samvasta/wing_it_hardware/Parts.md

# Parts

## Board Connection

### Main board

Plug: <https://www.digikey.com/product-detail/en/hirose-electric-co-ltd/PCN13-20S-2-54DS-71/H11185-ND/1036436>

### Hands

Receptacle: <https://www.digikey.com/product-detail/en/hirose-electric-co-ltd/PCN10-20P-2-54DS-72/H11156-ND/1036416>

## Module

To enable hot-swappable I2C modules, use one [PI6ULS5V9511AWEX](<https://www.digikey.com/product-detail/en/diodes-incorporated/PI6ULS5V9511AWEX/PI6ULS5V9511AWEXDICT-ND/8611258>) per module board.

### Analog Joystick

Tilt guard: 1.5mm acrylic sheet. See `cad/thumbstick_tilt_guard.dxf`

Standoff: [Würth Elektronik M3 6mm male-female hex standoff (digikey)](<https://www.digikey.com/product-detail/en/w%C3%BCrth-elektronik/971060321/732-10384-ND/6174603>)
