samvasta/wing_it_hardware/cad/specs.md

# CAD Specifications

## Holes

Prefer Imperial #4-40 hardware (screws, nuts, etc.).

_#4-40 nominal outer diameter:_ 2.84mm

_#4-40 clearance hole diameter:_ 3.25mm

## Parts

### Analog Thumbstick

The tilt stop is a circle 20mm diameter. Top of tilt stop is about 1/16" (17.48mm) from top of pcb.

Example: 1.5mm thick acrylic on top of 6mm standoff
