samvasta/wing_it_hardware/cad/kicad_import_pcb_main2.dxf

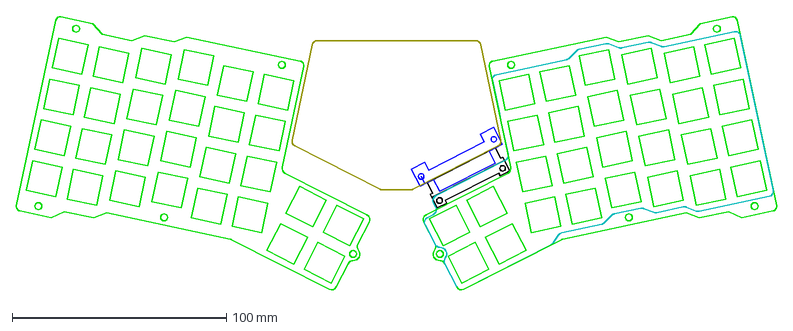
[picture p1: CAD file, 2020-05-02]
cad/kicad_import_pcb_main2.dxf
355.1 x 128.1 mm
