samvasta/wing_it_hardware/cad/kicad_import_pcb_main.dxf

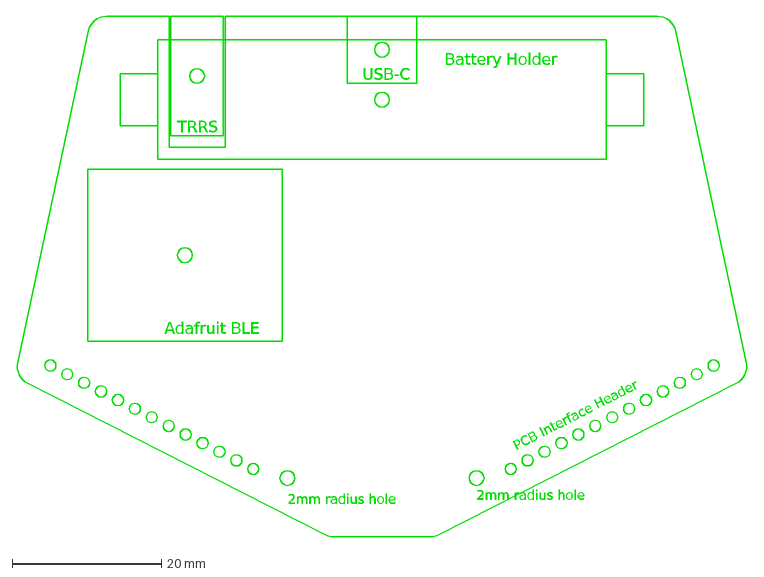
[picture p2: CAD file, 2020-04-02]
cad/kicad_import_pcb_main.dxf
USB-C
TRRS
Battery Holder
Adafruit BLE
2mm radius hole
PCB Interface Header
