samvasta/wing_it_hardware/cad/#all_in_one.dxf

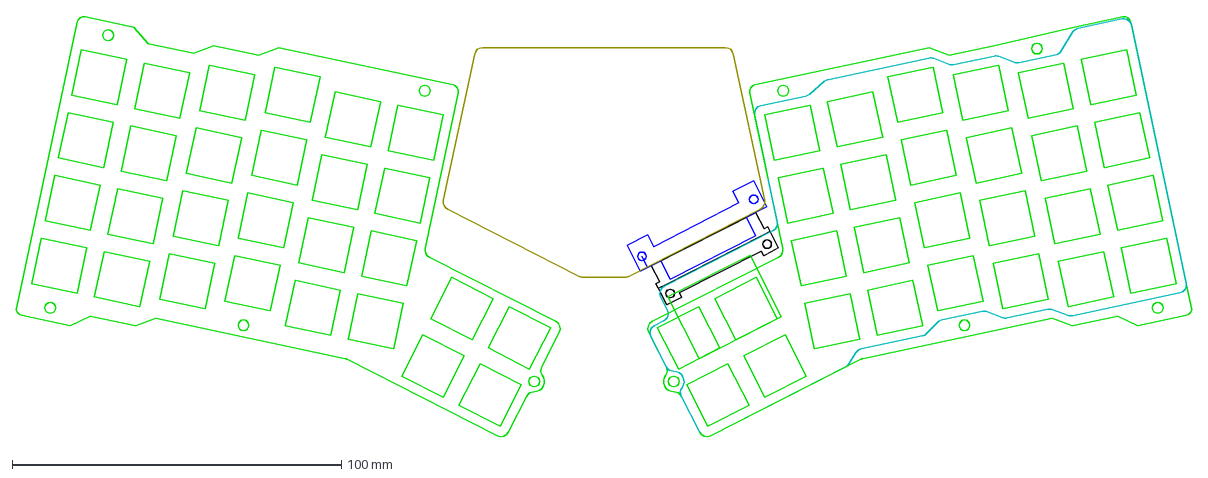
[picture p3: CAD file, 2020-05-28]
cad/#all_in_one.dxf
356.9 x 128.1 mm
