samvasta/wing_it_hardware/cad/kicad_import_pcb_hand2.dxf

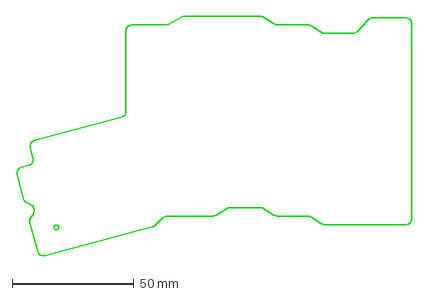
[picture p4: CAD file, 2020-05-02]
cad/kicad_import_pcb_hand2.dxf
162.7 x 98.8 mm
