samvasta/wing_it_hardware/cad/export_hand_bottom_plate.dxf

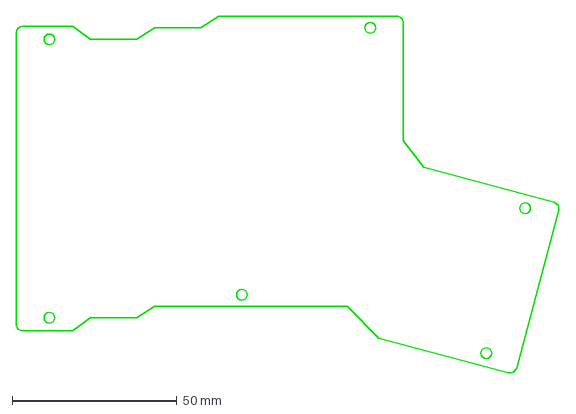
[picture p5: CAD file, 2020-04-14]
cad/export_hand_bottom_plate.dxf
165.1 x 108.6 mm
