samvasta/wing_it_hardware/cad/thumbstick_tilt_guard.dxf

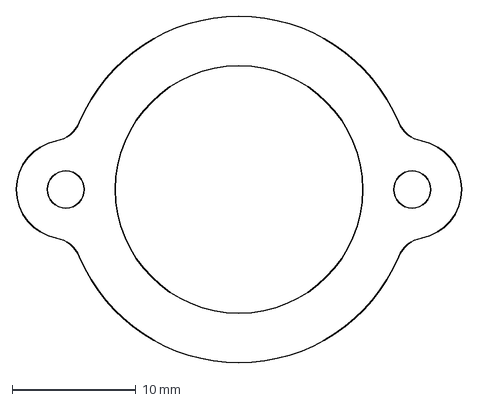
[picture p7: CAD file, 2020-04-05]
cad/thumbstick_tilt_guard.dxf
36.0 x 28.0 mm
