samvasta/wing_it_hardware/cad/kicad_import_pcb_hand.dxf

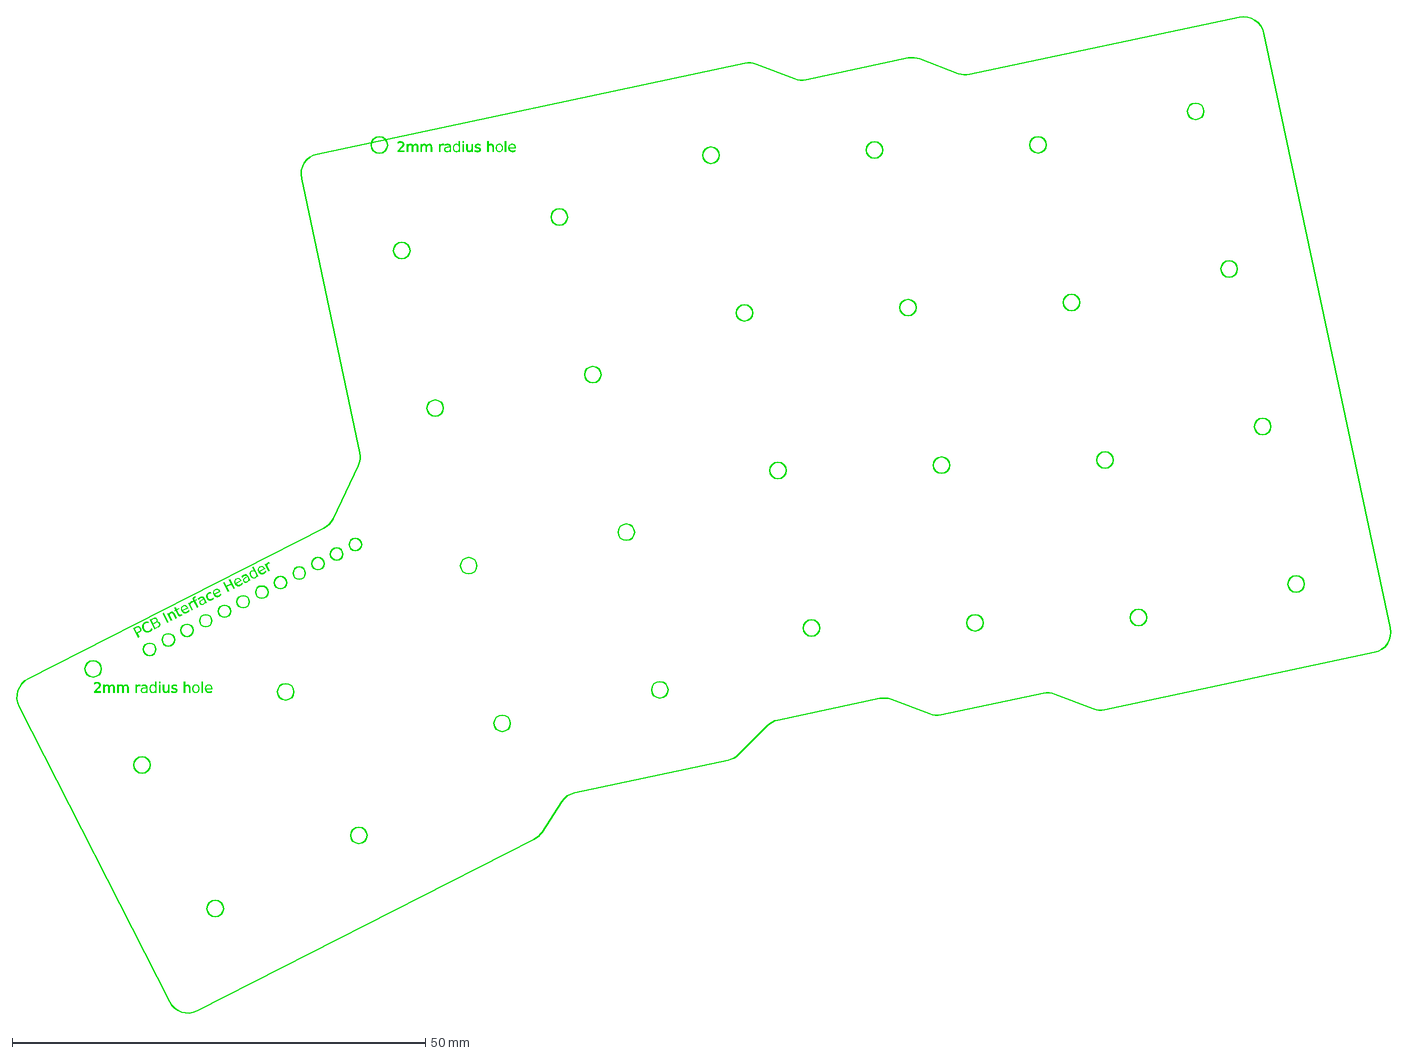
[picture p8: CAD file, 2020-04-02]
cad/kicad_import_pcb_hand.dxf
2mm radius hole
PCB Interface Header
