samvasta/wing_it_hardware/cad/kicad_import_switch_positions.dxf

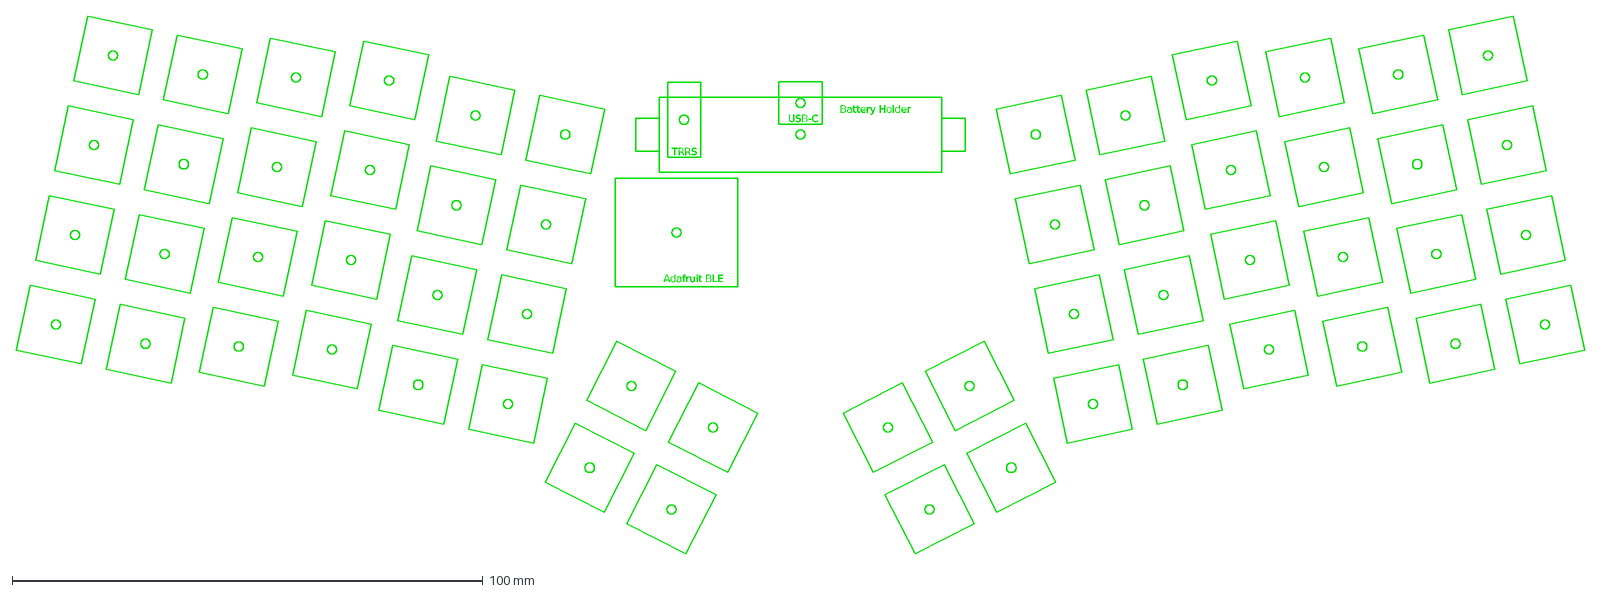
[picture p9: CAD file, 2020-03-29]
cad/kicad_import_switch_positions.dxf
USB-C
TRRS
Battery Holder
Adafruit BLE
