samvasta/wing_it_hardware/(list of files, cad)

Other CAD files:
cad/all_in_one.dxf
