samvasta/wing_it_hardware/pcb/pcb_hand/Keeb.kicad_pcb

## KiCad design pcb/pcb_hand/Keeb.kicad_pcb (2020-05-02)

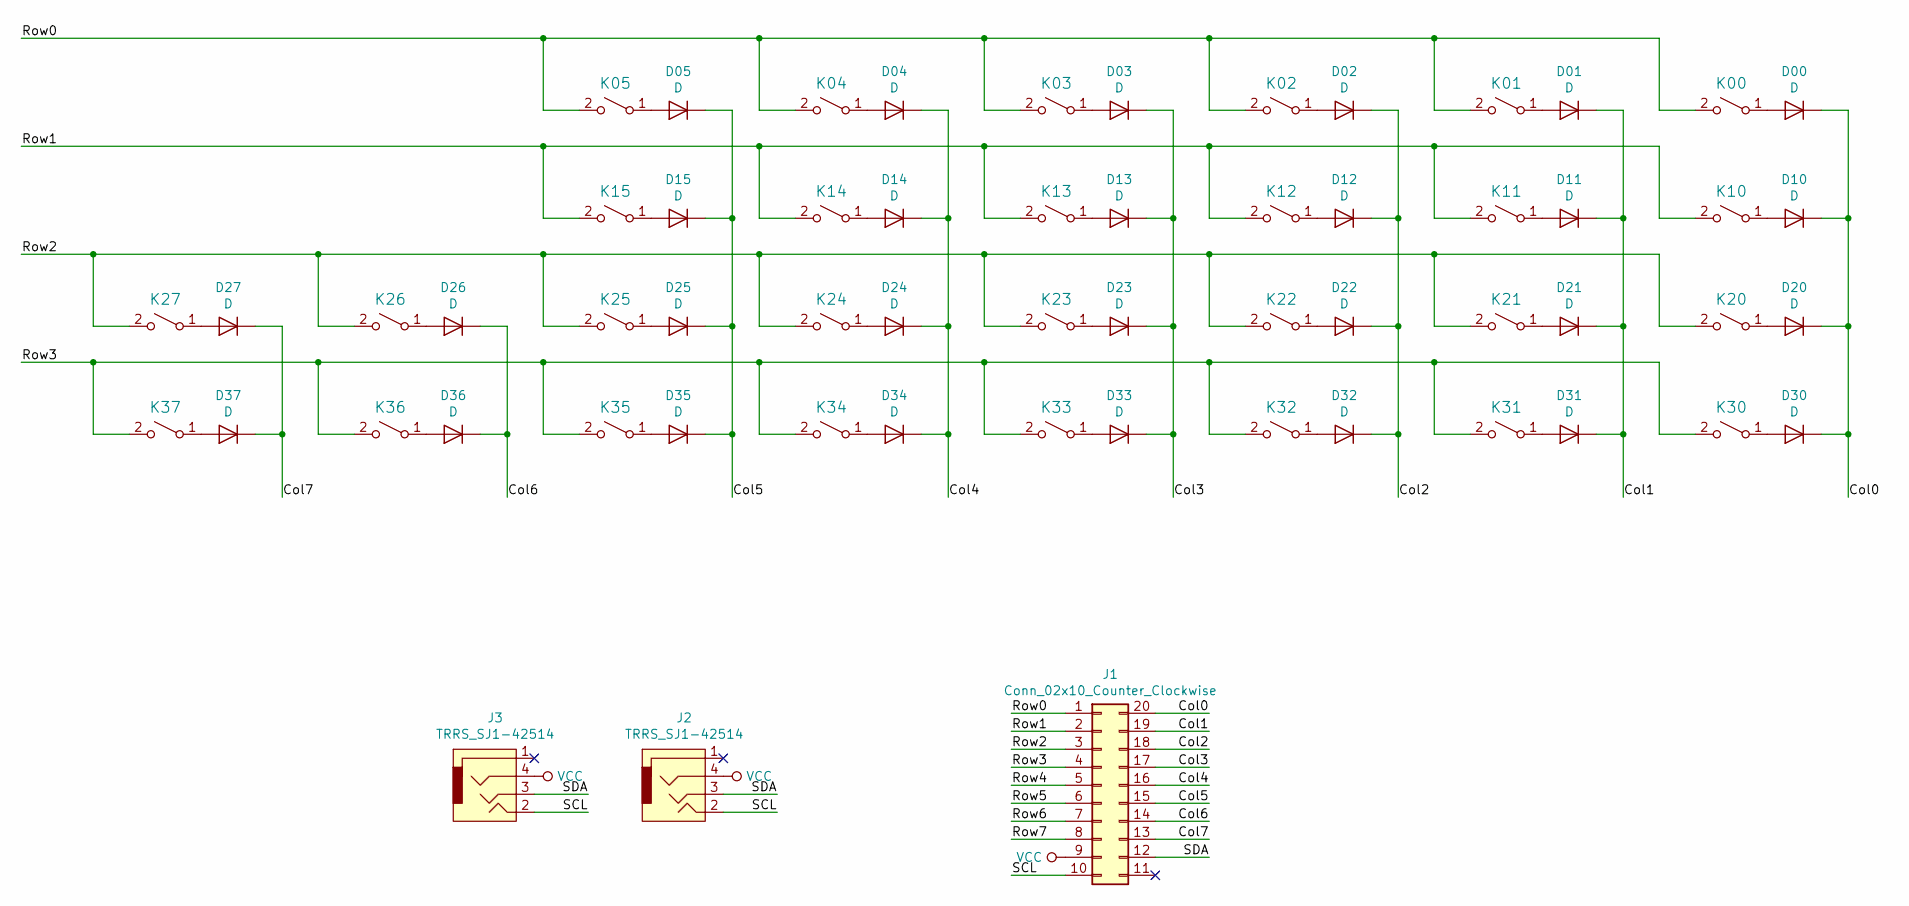
[picture p10: schematic Keeb.sch]

Parts:
D00, D01, D02, D03, D04, D05, D10, D11, D12, D13, D14, D15, D20, D21, D22, D23, D24, D25, D26, D27, D30, D31, D32, D33, D34, D35, D36, D37: D; D_MiniMELF_Handsoldering_Shorter_Pads_DoubleSided
J1: Conn_02x10_Counter_Clockwise; Backplane_Connector_Hirose_PCN_20pos_Receptacle
J2, J3: TRRS_SJ1-42514; 3.5mm_Cut_out
K00, K01, K02, K03, K04, K05, K10, K11, K12, K13, K14, K15, K20, K21, K22, K23, K24, K25, K26, K27, K30, K31, K32, K33, K34, K35, K36, K37: KEYSW; Kailh_socket_reversible

Connections:
/Col0: D00.1 (K), D10.1 (K), D20.1 (K), D30.1 (K), J1.20
/Col1: D01.1 (K), D11.1 (K), D21.1 (K), D31.1 (K), J1.19
/Col2: D02.1 (K), D12.1 (K), D22.1 (K), D32.1 (K), J1.18
/Col3: D03.1 (K), D13.1 (K), D23.1 (K), D33.1 (K), J1.17
/Col4: D04.1 (K), D14.1 (K), D24.1 (K), D34.1 (K), J1.16
/Col5: D05.1 (K), D15.1 (K), D25.1 (K), D35.1 (K), J1.15
/Col6: D26.1 (K), D36.1 (K), J1.14
/Col7: D27.1 (K), D37.1 (K), J1.13
/Row0: J1.1, K00.2 (B), K01.2 (B), K02.2 (B), K03.2 (B), K04.2 (B), K05.2 (B)
/Row1: J1.2, K10.2 (B), K11.2 (B), K12.2 (B), K13.2 (B), K14.2 (B), K15.2 (B)
/Row2: J1.3, K20.2 (B), K21.2 (B), K22.2 (B), K23.2 (B), K24.2 (B), K25.2 (B), K26.2 (B), K27.2 (B)
/Row3: J1.4, K30.2 (B), K31.2 (B), K32.2 (B), K33.2 (B), K34.2 (B), K35.2 (B), K36.2 (B), K37.2 (B)
/Row4: J1.5
/Row5: J1.6
/Row6: J1.7
/Row7: J1.8
/SCL: J1.10, J2.2, J3.2
/SDA: J1.12, J2.3, J3.3
unnamed: D00.2 (A), K00.1 (A)
unnamed: D01.2 (A), K01.1 (A)
unnamed: D02.2 (A), K02.1 (A)
unnamed: D03.2 (A), K03.1 (A)
unnamed: D04.2 (A), K04.1 (A)
unnamed: D05.2 (A), K05.1 (A)
unnamed: D10.2 (A), K10.1 (A)
unnamed: D11.2 (A), K11.1 (A)
unnamed: D12.2 (A), K12.1 (A)
unnamed: D13.2 (A), K13.1 (A)
unnamed: D14.2 (A), K14.1 (A)
unnamed: D15.2 (A), K15.1 (A)
unnamed: D20.2 (A), K20.1 (A)
unnamed: D21.2 (A), K21.1 (A)
unnamed: D22.2 (A), K22.1 (A)
unnamed: D23.2 (A), K23.1 (A)
unnamed: D24.2 (A), K24.1 (A)
unnamed: D25.2 (A), K25.1 (A)
unnamed: D26.2 (A), K26.1 (A)
unnamed: D27.2 (A), K27.1 (A)
unnamed: D30.2 (A), K30.1 (A)
unnamed: D31.2 (A), K31.1 (A)
unnamed: D32.2 (A), K32.1 (A)
unnamed: D33.2 (A), K33.1 (A)
unnamed: D34.2 (A), K34.1 (A)
unnamed: D35.2 (A), K35.1 (A)
unnamed: D36.2 (A), K36.1 (A)
unnamed: D37.2 (A), K37.1 (A)
VCC: J1.9, J2.4, J3.4

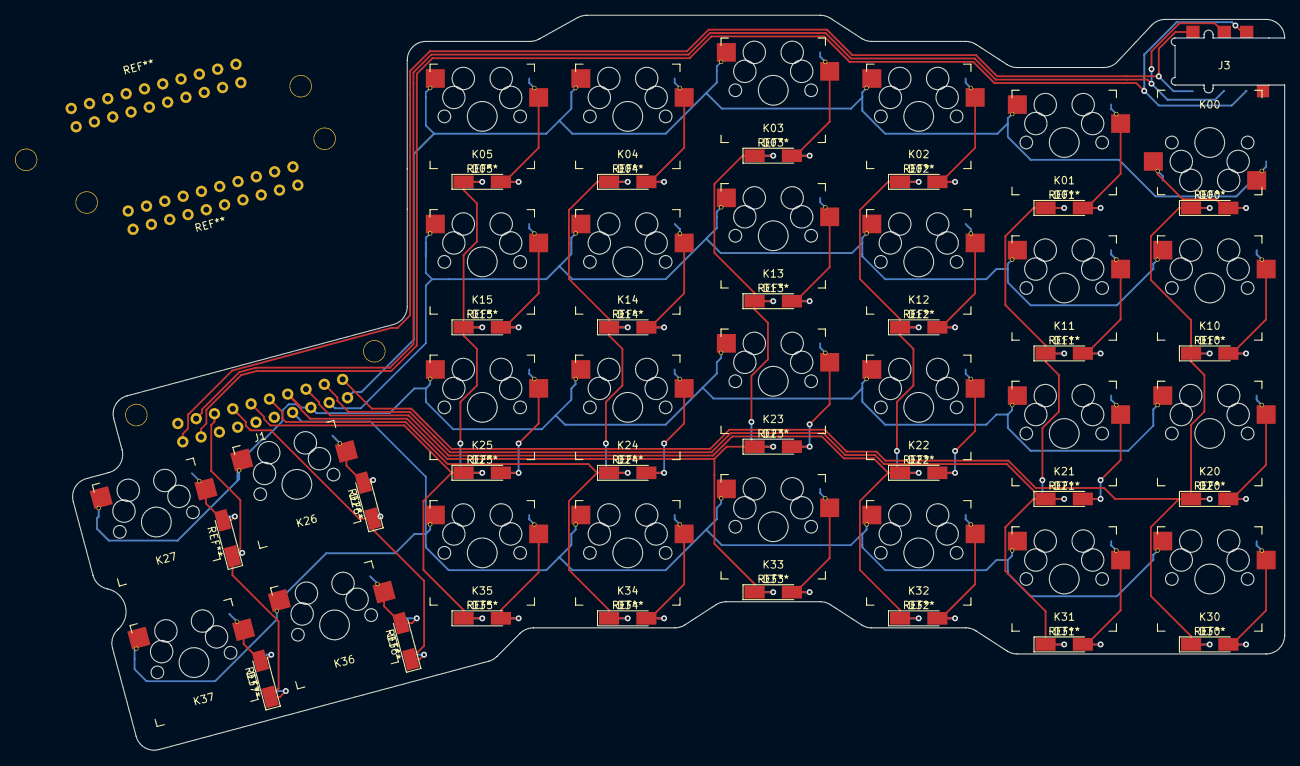
[picture p11: board pcb/pcb_hand/Keeb.kicad_pcb from above]

Board: 2 copper layers, 162.5 x 98.5 mm, 59 parts (1 on the bottom side), 43 nets.
