samvasta/wing_it_hardware/pcb/pcb_main/Keeb.kicad_pcb

## KiCad design pcb/pcb_main/Keeb.kicad_pcb (2020-05-02)

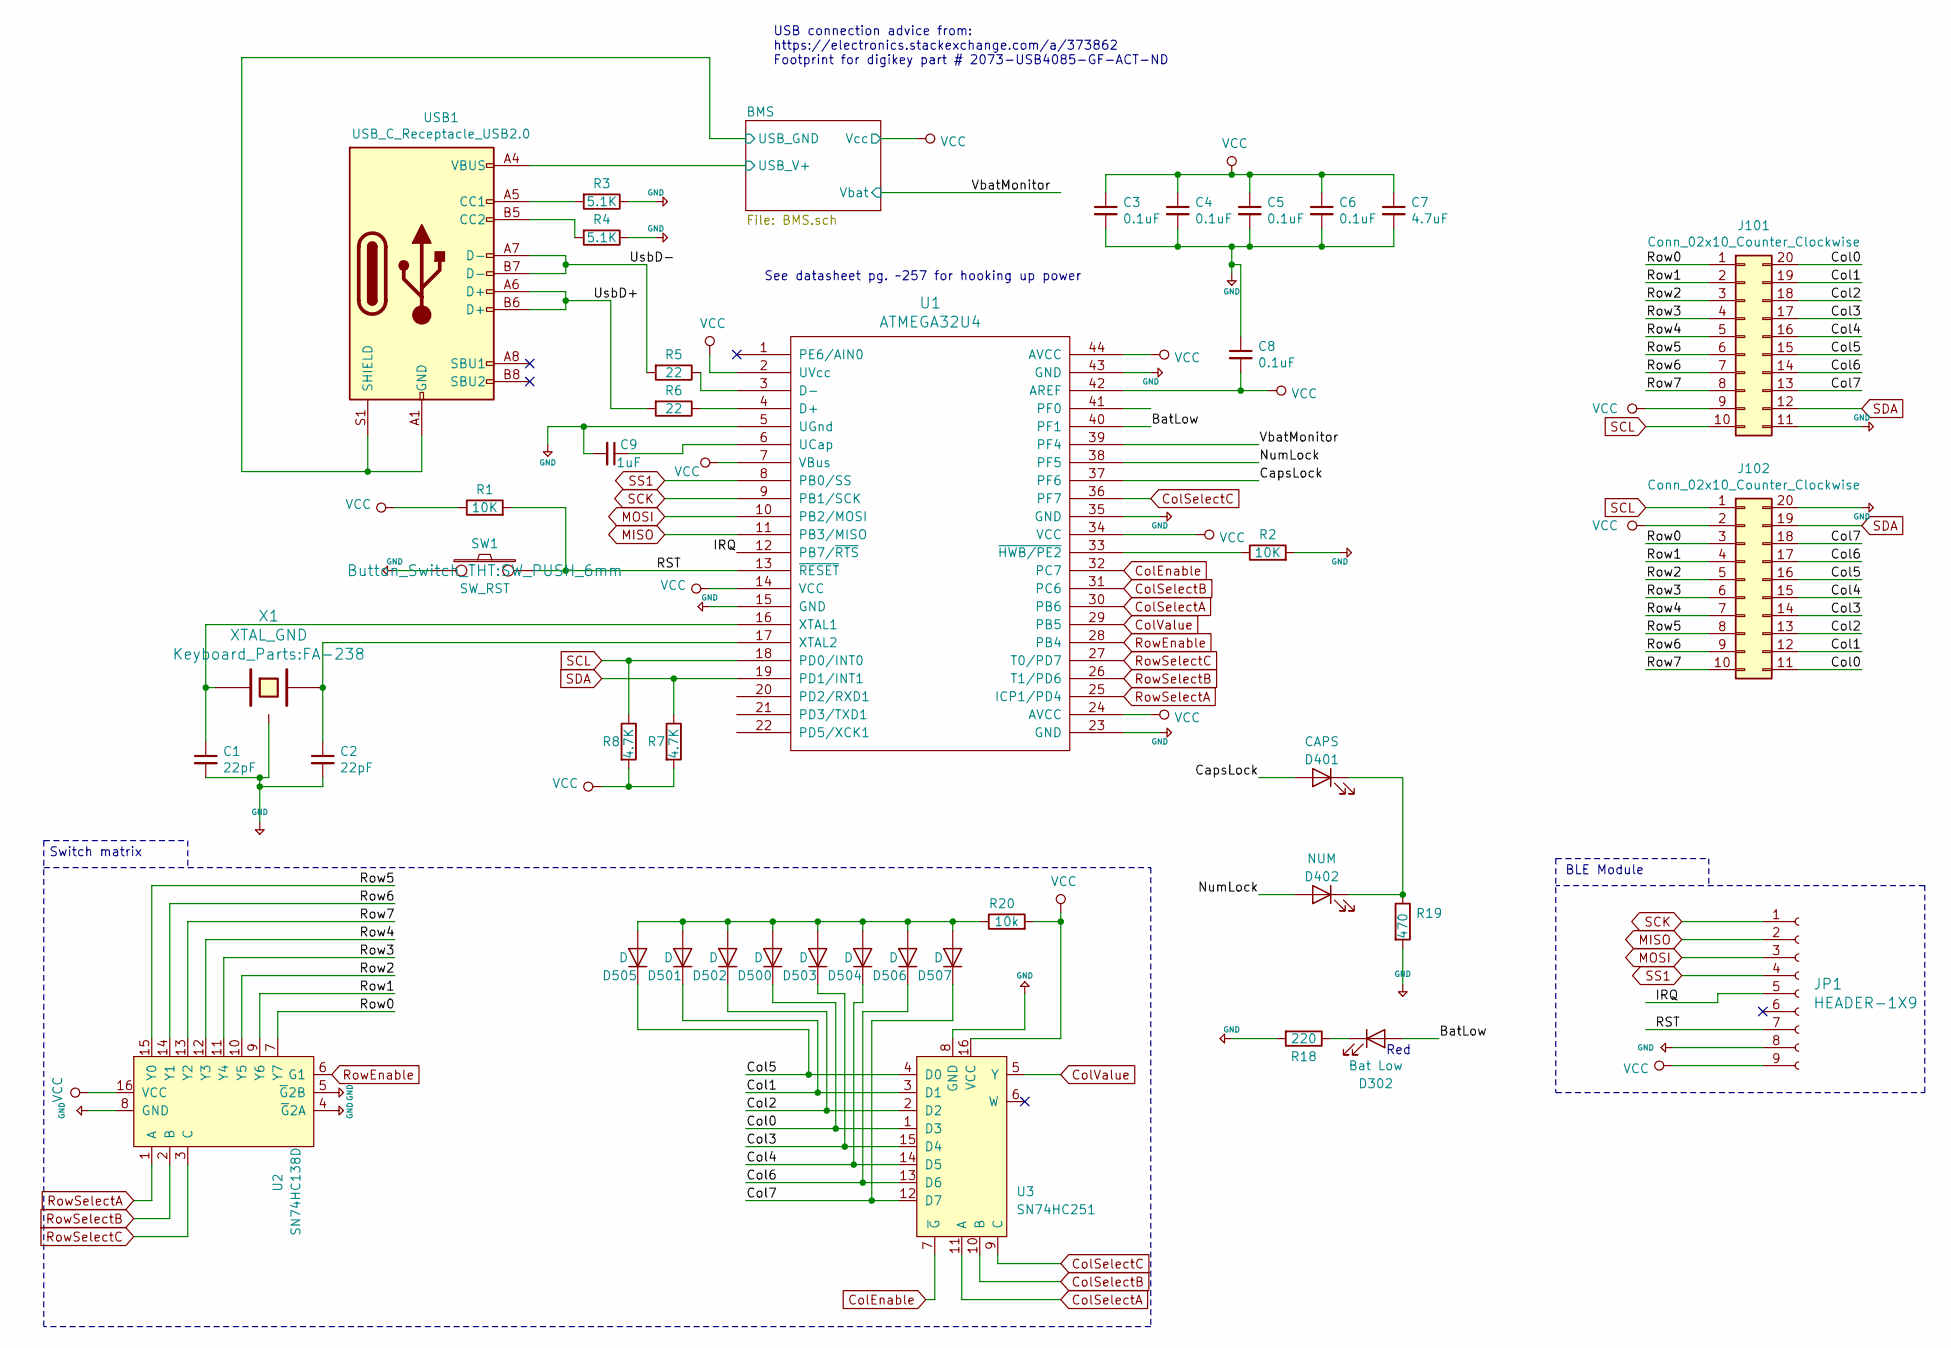
[picture p12: schematic Keeb.sch]

Parts:
C1, C2: 22pF; C_0805_2012Metric_Pad1.15x1.40mm_HandSolder
C3, C4, C5, C6, C8: 0.1uF; C_0805_2012Metric_Pad1.15x1.40mm_HandSolder
C7: 4.7uF; C_0805_2012Metric_Pad1.15x1.40mm_HandSolder
C9: 1uF; C_0805_2012Metric_Pad1.15x1.40mm_HandSolder
D302: Bat Low; LED_0805_2012Metric_Pad1.15x1.40mm_HandSolder
D401: CAPS; LED_0805_2012Metric_Pad1.15x1.40mm_HandSolder
D402: NUM; LED_0805_2012Metric_Pad1.15x1.40mm_HandSolder
D500, D501, D502, D503, D504, D505, D506, D507: D; D_0805_2012Metric_Pad1.15x1.40mm_HandSolder
J101, J102: Conn_02x10_Counter_Clockwise; Backplane_Connector_Hirose_PCN_20pos_Plug
JP1: HEADER-1X9; Adafruit_BLE_SPI_wire_tht
R1, R2: 10K; R_0805_2012Metric_Pad1.15x1.40mm_HandSolder
R3, R4: 5.1K; R_0805_2012Metric_Pad1.15x1.40mm_HandSolder
R5, R6: 22; R_0805_2012Metric_Pad1.15x1.40mm_HandSolder
R7, R8: 4.7K; R_0805_2012Metric_Pad1.15x1.40mm_HandSolder
R18: 220; R_0805_2012Metric_Pad1.15x1.40mm_HandSolder
R19: 470; R_0805_2012Metric_Pad1.15x1.40mm_HandSolder
R20: 10k; R_0805_2012Metric_Pad1.15x1.40mm_HandSolder
SW1: SW_RST; SW_PUSH_6mm
U1: ATMEGA32U4; ATMEGA32U4-AU
U2: SN74HC138D‎; SN74HC_package_d_soic
U3: SN74HC251; SN74HC_package_d_soic
USB1: USB_C_Receptacle_USB2.0; USB_C_Receptacle_GCT_USB4085
X1: XTAL_GND; FA-238

Connections:
/BMS/USB_V+: USB1.A4 (VBUS), USB1.A9 (VBUS), USB1.B4 (VBUS), USB1.B9 (VBUS); also elsewhere on the board
/BatLow: D302.2 (A), U1.40 (PF1)
/CapsLock: D401.2 (A), U1.37 (PF6)
/Col0: D500.1 (K), J101.20, J102.11, U3.1 (D3)
/Col1: D501.1 (K), J101.19, J102.12, U3.3 (D1)
/Col2: D502.1 (K), J101.18, J102.13, U3.2 (D2)
/Col3: D503.1 (K), J101.17, J102.14, U3.15 (D4)
/Col4: D504.1 (K), J101.16, J102.15, U3.14 (D5)
/Col5: D505.1 (K), J101.15, J102.16, U3.4 (D0)
/Col6: D506.1 (K), J101.14, J102.17, U3.13 (D6)
/Col7: D507.1 (K), J101.13, J102.18, U3.12 (D7)
/IRQ: JP1.5, U1.12 (PB7/~RTS)
/NumLock: D402.2 (A), U1.38 (PF5)
/RST: JP1.7, R1.2, SW1.2, U1.13 (~RESET)
/Row0: J101.1, J102.3, U2.7 (Y7)
/Row1: J101.2, J102.4, U2.9 (Y6)
/Row2: J101.3, J102.5, U2.10 (Y5)
/Row3: J101.4, J102.6, U2.11 (Y4)
/Row4: J101.5, J102.7, U2.12 (Y3)
/Row5: J101.6, J102.8, U2.15 (Y0)
/Row6: J101.7, J102.9, U2.14 (Y1)
/Row7: J101.8, J102.10, U2.13 (Y2)
/UsbD+: R6.2, USB1.A6 (D+), USB1.B6 (D+)
/UsbD-: R5.2, USB1.A7 (D-), USB1.B7 (D-)
/VbatMonitor: U1.39 (PF4); also elsewhere on the board
ColEnable: U1.32 (PC7), U3.7 (~G)
ColSelectA: U1.30 (PB6), U3.11 (A)
ColSelectB: U1.31 (PC6), U3.10 (B)
ColSelectC: U1.36 (PF7), U3.9 (C)
ColValue: U1.29 (PB5), U3.5 (Y)
GND: C1.2, C2.2, C3.2, C4.2, C5.2, C6.2, C7.2, C8.1, C9.2, J101.11, J102.20, JP1.8, R2.2, R3.1, R4.1, R18.2, R19.2, SW1.1, U1.5 (UGnd), U1.15 (GND), U1.23 (GND), U1.35 (GND), U1.43 (GND), U2.4 (~G~2A), U2.5 (~G~2B), U2.8 (GND), U3.8 (GND), USB1.A1 (GND), USB1.A12 (GND), USB1.B1 (GND), USB1.B12 (GND), USB1.S1 (SHIELD), X1.3; also elsewhere on the board
MISO: JP1.2, U1.11 (PB3/MISO)
MOSI: JP1.3, U1.10 (PB2/MOSI)
unnamed: C1.1, U1.16 (XTAL1), X1.1
unnamed: C2.1, U1.17 (XTAL2), X1.2
unnamed: C9.1, U1.6 (UCap)
unnamed: D302.1 (K), R18.1
unnamed: D401.1 (K), D402.1 (K), R19.1
unnamed: D500.2 (A), D501.2 (A), D502.2 (A), D503.2 (A), D504.2 (A), D505.2 (A), D506.2 (A), D507.2 (A), R20.1
unnamed: R2.1, U1.33 (~HWB/PE2)
unnamed: R3.2, USB1.A5 (CC1)
unnamed: R4.2, USB1.B5 (CC2)
unnamed: R5.1, U1.3 (D-)
unnamed: R6.1, U1.4 (D+)
RowEnable: U1.28 (PB4), U2.6 (G1)
RowSelectA: U1.25 (ICP1/PD4), U2.1 (A)
RowSelectB: U1.26 (T1/PD6), U2.2 (B)
RowSelectC: U1.27 (T0/PD7), U2.3 (C)
SCK: JP1.1, U1.9 (PB1/SCK)
SCL: J101.10, J102.1, R8.1, U1.18 (PD0/INT0)
SDA: J101.12, J102.19, R7.1, U1.19 (PD1/INT1)
SS1: JP1.4, U1.8 (PB0/SS)
VCC: C3.1, C4.1, C5.1, C6.1, C7.1, C8.2, J101.9, J102.2, JP1.9, R1.1, R7.2, R8.2, R20.2, U1.2 (UVcc), U1.7 (VBus), U1.14 (VCC), U1.24 (AVCC), U1.34 (VCC), U1.42 (AREF), U1.44 (AVCC), U2.16 (VCC), U3.16 (VCC); also elsewhere on the board

Notes on the sheet:
USB connection advice from: https://electronics.stackexchange.com/a/373862 Footprint for digikey part # 2073-USB4085-GF-ACT-ND
See datasheet pg. ~~257 for hooking up power
Switch matrix
BLE Module
Red

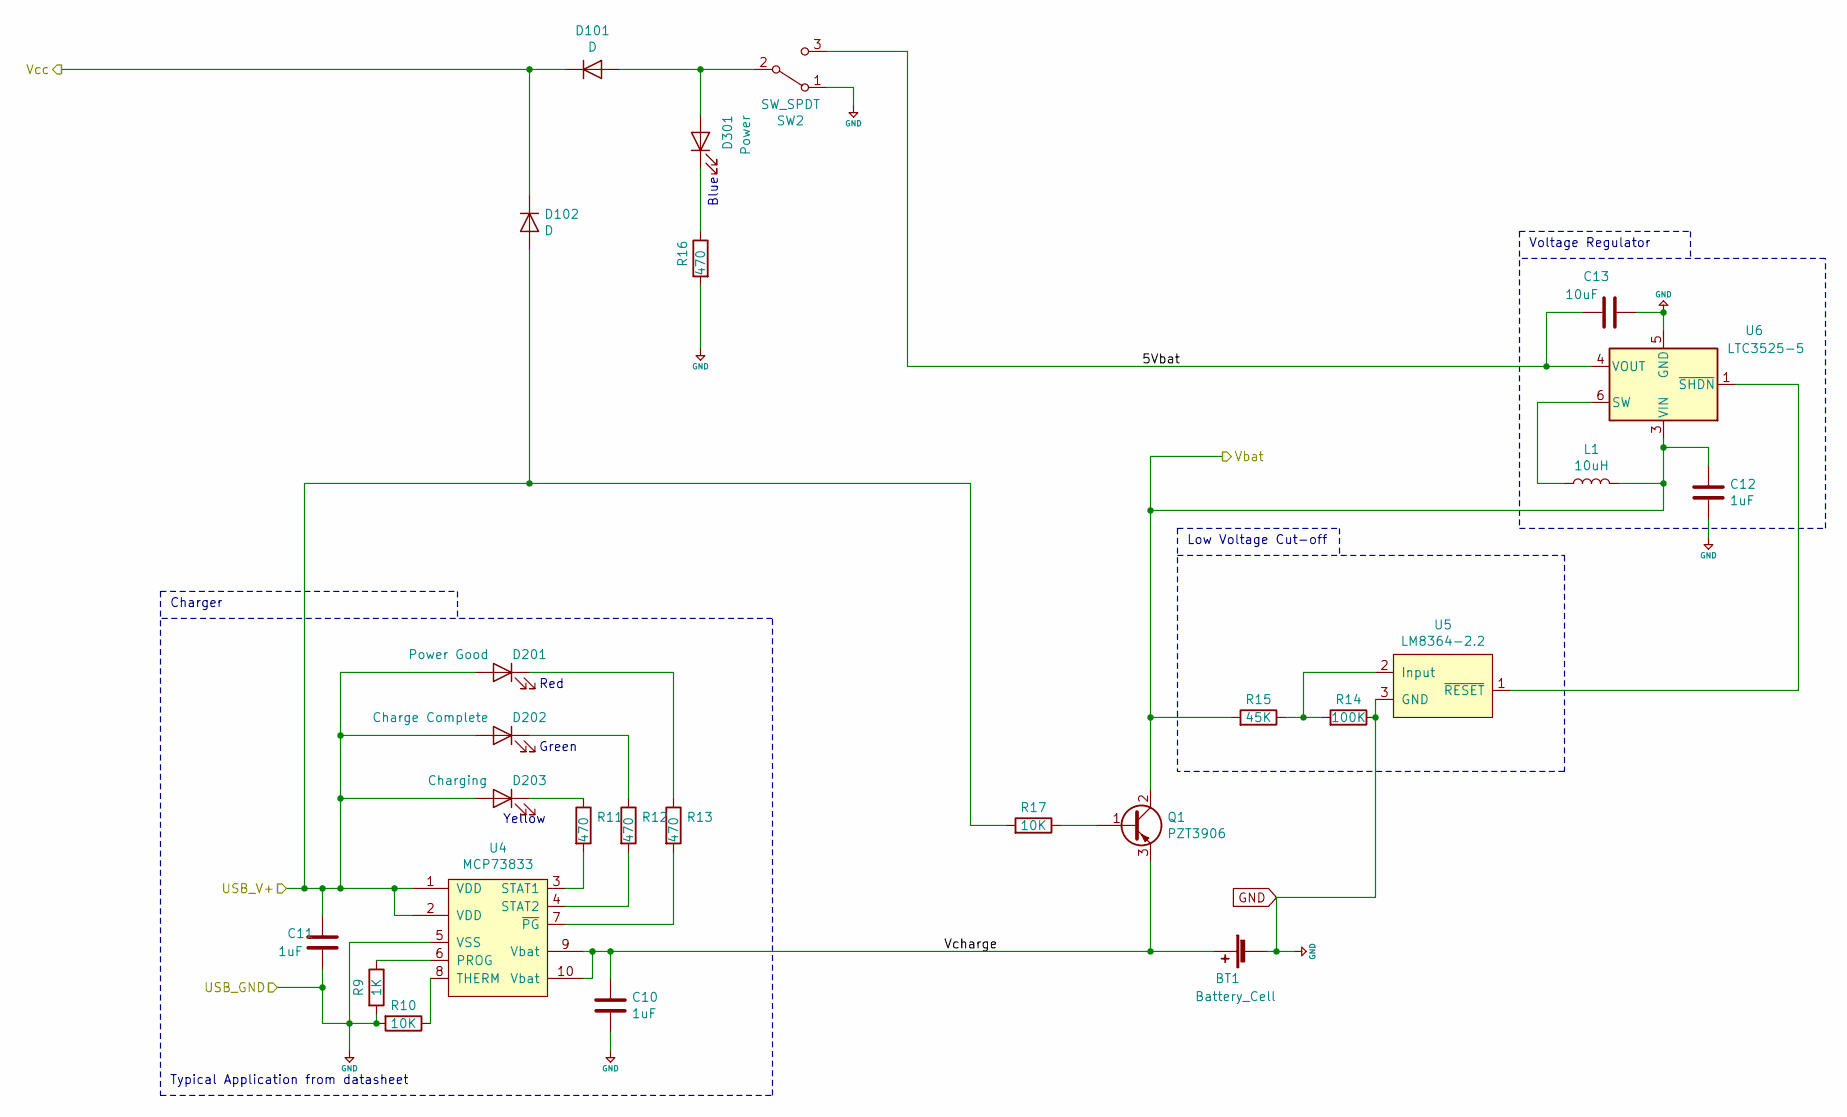
[picture p13: schematic BMS.sch]

Parts:
BT1: Battery_Cell; BatteryHolder_Keystone_1088_1xAA
C10, C11, C12: 1uF; C_0805_2012Metric_Pad1.15x1.40mm_HandSolder
C13: 10uF; C_0805_2012Metric_Pad1.15x1.40mm_HandSolder
D101, D102: D; D_MiniMELF_Handsoldering_Shorter_Pads
D201: Power Good; LED_0805_2012Metric_Pad1.15x1.40mm_HandSolder
D202: Charge Complete; LED_0805_2012Metric_Pad1.15x1.40mm_HandSolder
D203: Charging; LED_0805_2012Metric_Pad1.15x1.40mm_HandSolder
D301: Power; LED_0805_2012Metric_Pad1.15x1.40mm_HandSolder
L1: 10uH; L_0805_2012Metric_Pad1.15x1.40mm_HandSolder
Q1: PZT3906; SOT-223
R9: 1K; R_0805_2012Metric_Pad1.15x1.40mm_HandSolder
R10, R17: 10K; R_0805_2012Metric_Pad1.15x1.40mm_HandSolder
R11, R12, R13, R16: 470; R_0805_2012Metric_Pad1.15x1.40mm_HandSolder
R14: 100K; R_0805_2012Metric_Pad1.15x1.40mm_HandSolder
R15: 45K; R_0805_2012Metric_Pad1.15x1.40mm_HandSolder
SW2: SW_SPDT; SW_Slide_C&K_JS102011SAQN
U4: MCP73833; MCP73833T-AMI-UN
U5: LM8364-2.2; SOT-23-5_HandSoldering
U6: LTC3525-5; SOT-363_SC-70-6_Handsoldering

Connections:
/BMS/5Vbat: C13.2, SW2.3 (C), U6.4 (VOUT)
/BMS/USB_V+: C11.1, D102.2 (A), D201.2 (A), D202.2 (A), D203.2 (A), R17.2, U4.1 (VDD), U4.2 (VDD); also elsewhere on the board
/BMS/Vcharge: BT1.1 (+), C10.1, Q1.3 (E), U4.9 (Vbat), U4.10 (Vbat)
/VbatMonitor: C12.1, L1.1, Q1.2 (C), Q1.4 (C), R15.2, U6.3 (VIN); also elsewhere on the board
GND: BT1.2 (-), C10.2, C11.2, C12.2, C13.1, R9.2, R10.2, R14.1, R16.2, SW2.1 (A), U4.5 (VSS), U5.3 (GND), U6.2 (GND), U6.5 (GND); also elsewhere on the board
unnamed: D101.2 (A), D301.2 (A), SW2.2 (B)
unnamed: D201.1 (K), R13.1
unnamed: D202.1 (K), R12.1
unnamed: D203.1 (K), R11.1
unnamed: D301.1 (K), R16.1
unnamed: L1.2, U6.6 (SW)
unnamed: Q1.1 (B), R17.1
unnamed: R9.1, U4.6 (PROG)
unnamed: R10.1, U4.8 (THERM)
unnamed: R11.2, U4.3 (STAT1)
unnamed: R12.2, U4.4 (STAT2)
unnamed: R13.2, U4.7 (~PG)
unnamed: R14.2, R15.1, U5.2 (Input)
unnamed: U5.1 (~RESET), U6.1 (~SHDN)
VCC: D101.1 (K), D102.1 (K); also elsewhere on the board

Notes on the sheet:
Typical Application from datasheet
Charger
Low Voltage Cut-off
Green
Red
Yellow
Blue
Voltage Regulator

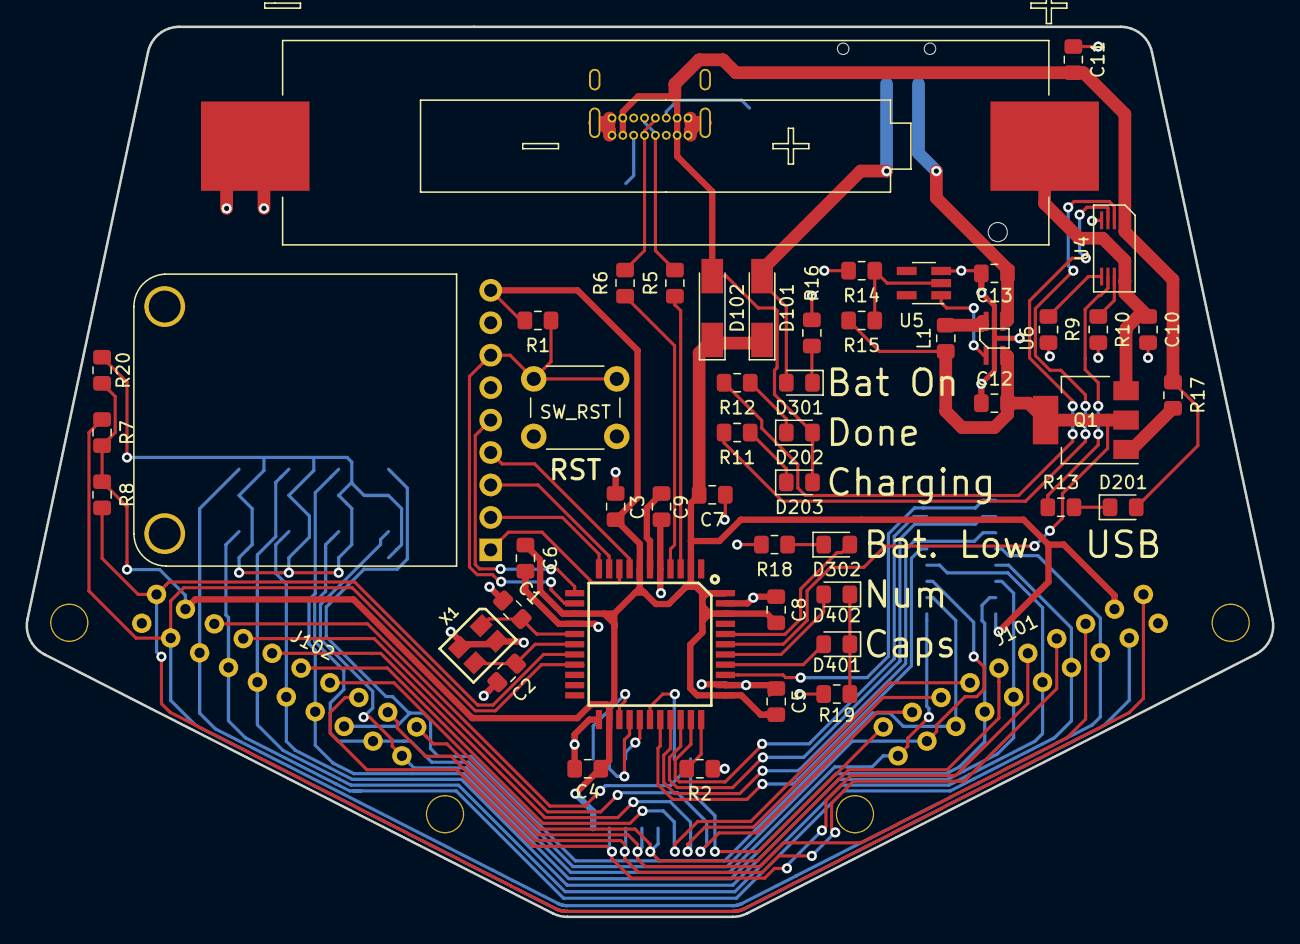
[picture p14: board pcb/pcb_main/Keeb.kicad_pcb from above]

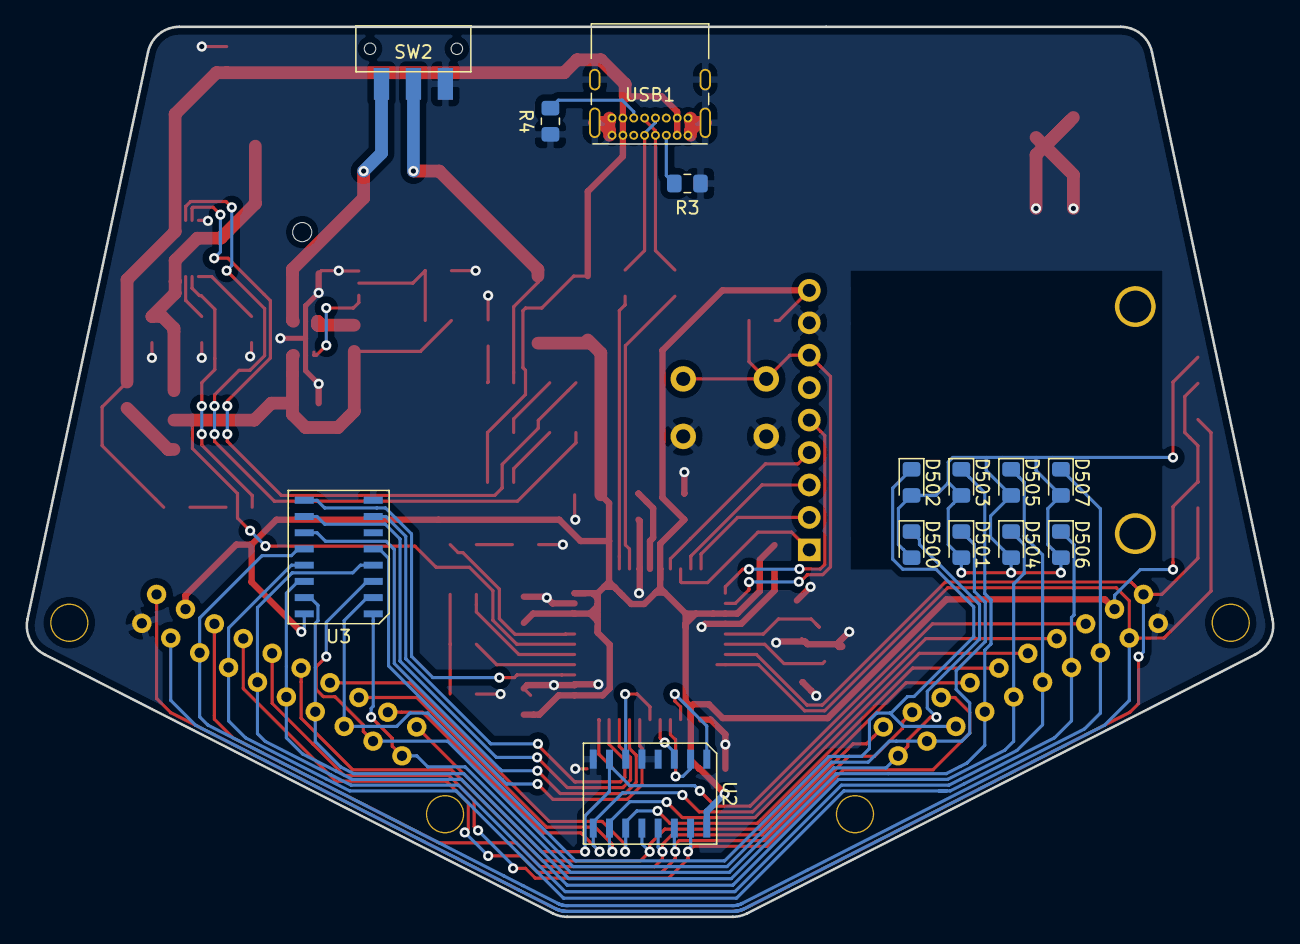
[picture p15: board pcb/pcb_main/Keeb.kicad_pcb from below]

Board: 2 copper layers, 97.6 x 69.7 mm, 66 parts (15 on the bottom side), 69 nets.
