samvasta/wing_it_hardware/pcb/pcb_module1/keeb.module1.kicad_pcb

## KiCad design pcb/pcb_module1/keeb.module1.kicad_pcb (2020-04-05)

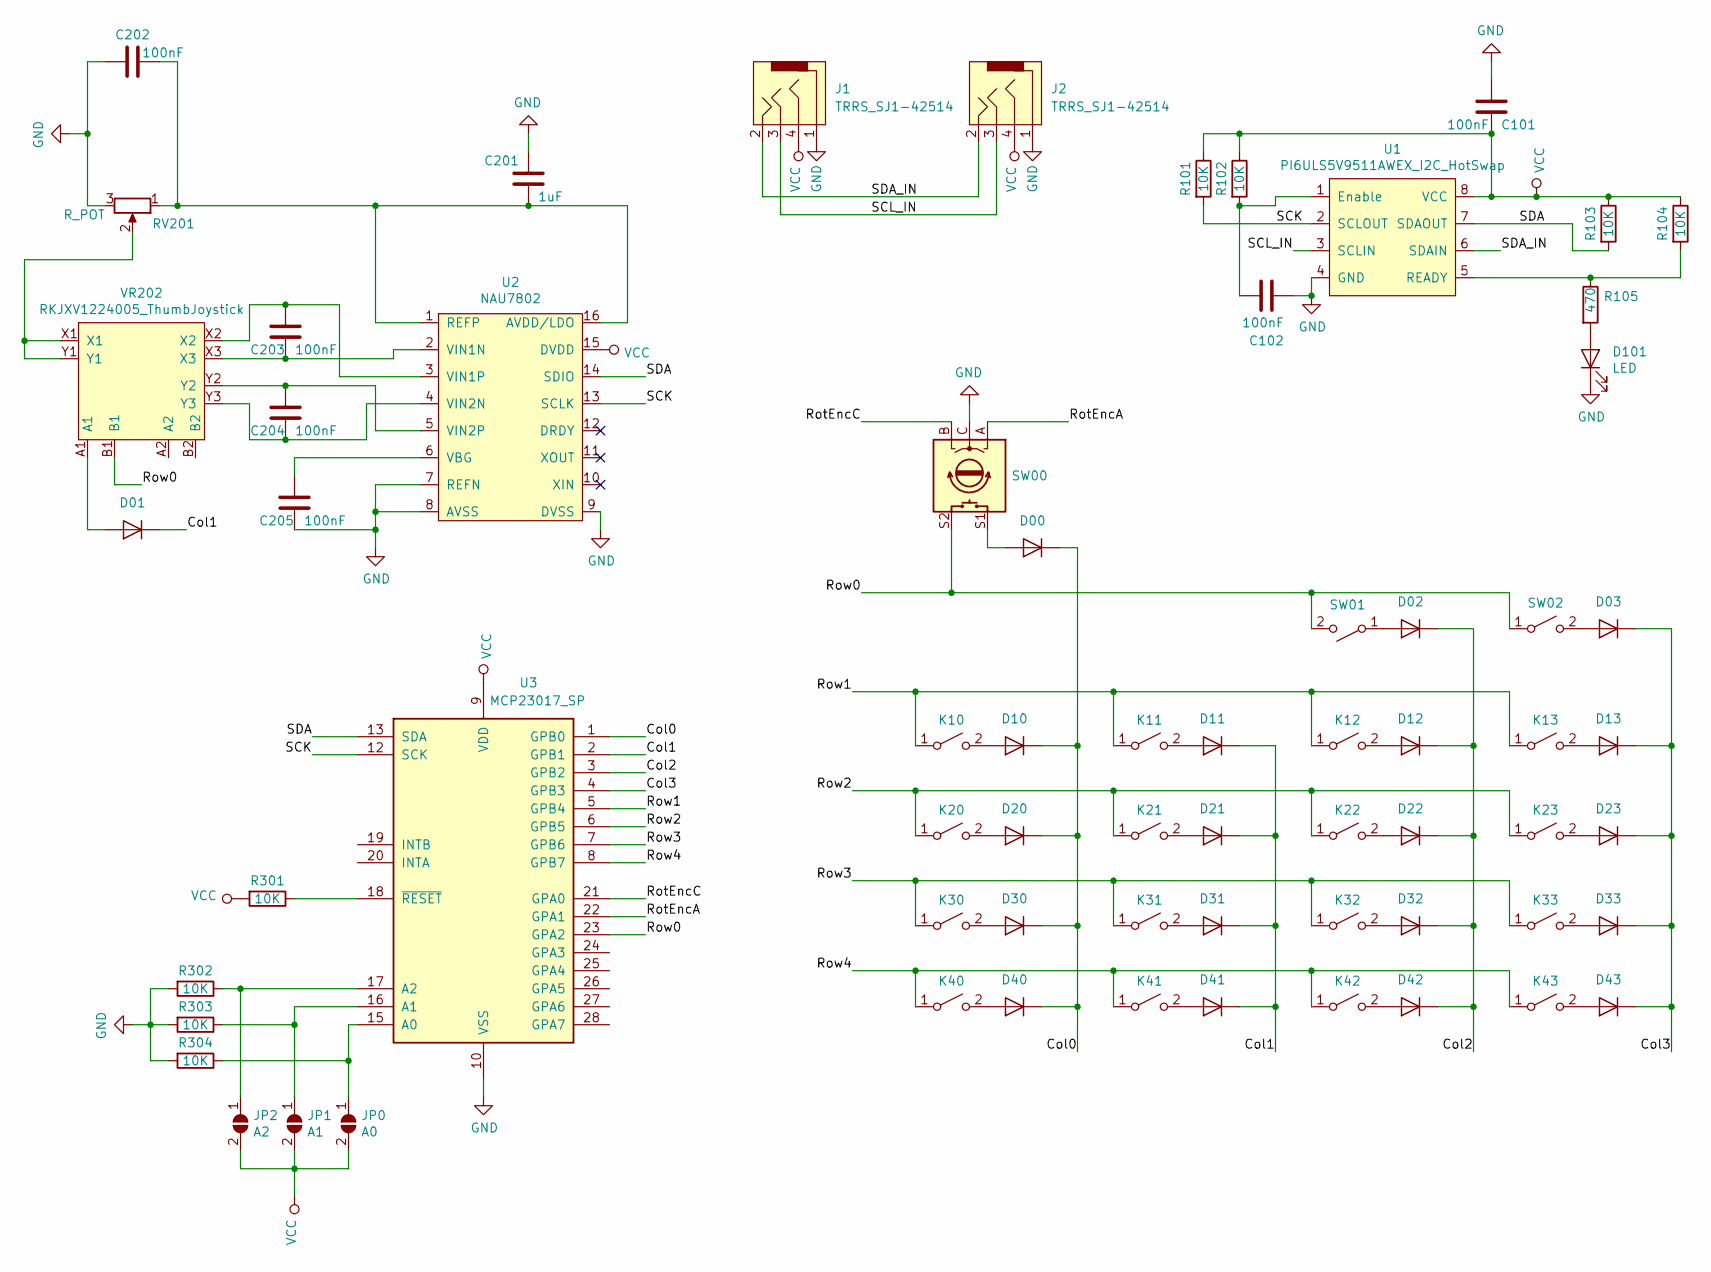
[picture p16: schematic keeb.module1.sch]

Parts:
C101, C102, C202, C203, C204, C205: 100nF; C_0805_2012Metric_Pad1.15x1.40mm_HandSolder
C201: 1uF; C_0805_2012Metric_Pad1.15x1.40mm_HandSolder
D00, D01, D02, D03, D10, D11, D12, D13, D20, D21, D22, D23, D30, D31, D32, D33, D40, D41, D42, D43: D; D_A-405_P7.62mm_Horizontal
D101: LED; D_0805_2012Metric_Pad1.15x1.40mm_HandSolder
J1, J2: TRRS_SJ1-42514; 3.5mm_Cut_out
JP0: A0; SolderJumper-2_P1.3mm_Open_RoundedPad1.0x1.5mm
JP1: A1; SolderJumper-2_P1.3mm_Open_RoundedPad1.0x1.5mm
JP2: A2; SolderJumper-2_P1.3mm_Open_RoundedPad1.0x1.5mm
K10, K11, K12, K13, K20, K21, K22, K23, K30, K31, K32, K33, K40, K41, K42, K43: SW_SPST; Kailh_socket_vias
R101, R102, R103, R104, R301, R302, R303, R304: 10K; Resistor-Compact
R105: 470; Resistor-Compact
RV201: R_POT; SlidePot_PS45M
SW00: Rotary_Encoder_Switch; PEC12R-4xxxF-Sxxxx_Rotary_Encoder
SW01, SW02: SW_SPST; B3J-1100_Switch
U1: PI6ULS5V9511AWEX_I2C_HotSwap; PI6ULS5V9511A_I2C_HotSwap
U2: NAU7802; DIP-16_W7.62mm
U3: MCP23017_SP; DIP-28_W7.62mm
VR202: RKJXV1224005_ThumbJoystick; RKJXV1224_AnalogJoystick

Connections:
/Col0: D00.1 (K), D10.1 (K), D20.1 (K), D30.1 (K), D40.1 (K), U3.1 (GPB0)
/Col1: D01.1 (K), D11.1 (K), D21.1 (K), D31.1 (K), D41.1 (K), U3.2 (GPB1)
/Col2: D02.1 (K), D12.1 (K), D22.1 (K), D32.1 (K), D42.1 (K), U3.3 (GPB2)
/Col3: D03.1 (K), D13.1 (K), D23.1 (K), D33.1 (K), D43.1 (K), U3.4 (GPB3)
/RotEncA: SW00.A, U3.22 (GPA1)
/RotEncC: SW00.B, U3.21 (GPA0)
/Row0: SW00.S2, SW01.2 (B), SW02.1 (A), U3.23 (GPA2), VR202.B1
/Row1: K10.1 (A), K11.1 (A), K12.1 (A), K13.1 (A), U3.5 (GPB4)
/Row2: K20.1 (A), K21.1 (A), K22.1 (A), K23.1 (A), U3.6 (GPB5)
/Row3: K30.1 (A), K31.1 (A), K32.1 (A), K33.1 (A), U3.7 (GPB6)
/Row4: K40.1 (A), K41.1 (A), K42.1 (A), K43.1 (A), U3.8 (GPB7)
/SCK: R101.2, U1.2 (SCLOUT), U2.13 (SCLK), U3.12 (SCK)
/SCL_IN: J1.3, J2.3, U1.3 (SCLIN)
/SDA: R103.2, U1.7 (SDAOUT), U2.14 (SDIO), U3.13 (SDA)
/SDA_IN: J1.2, J2.2, U1.6 (SDAIN)
GND: C101.1, C102.2, C201.1, C202.2, C205.2, D101.1 (K), J1.1, J2.1, R302.2, R303.2, R304.2, RV201.3, SW00.C, U1.4 (GND), U2.7 (REFN), U2.8 (AVSS), U2.9 (DVSS), U3.10 (VSS)
unnamed: C102.1, R102.2, U1.1 (Enable)
unnamed: C201.2, C202.1, RV201.1, U2.1 (REFP), U2.16 (AVDD/LDO)
unnamed: C203.1, U2.3 (VIN1P), VR202.X2
unnamed: C203.2, U2.2 (VIN1N), VR202.X3
unnamed: C204.1, U2.5 (VIN2P), VR202.Y2
unnamed: C204.2, U2.4 (VIN2N), VR202.Y3
unnamed: C205.1, U2.6 (VBG)
unnamed: D00.2 (A), SW00.S1
unnamed: D01.2 (A), VR202.A1
unnamed: D02.2 (A), SW01.1 (A)
unnamed: D03.2 (A), SW02.2 (B)
unnamed: D10.2 (A), K10.2 (B)
unnamed: D11.2 (A), K11.2 (B)
unnamed: D12.2 (A), K12.2 (B)
unnamed: D13.2 (A), K13.2 (B)
unnamed: D20.2 (A), K20.2 (B)
unnamed: D21.2 (A), K21.2 (B)
unnamed: D22.2 (A), K22.2 (B)
unnamed: D23.2 (A), K23.2 (B)
unnamed: D30.2 (A), K30.2 (B)
unnamed: D31.2 (A), K31.2 (B)
unnamed: D32.2 (A), K32.2 (B)
unnamed: D33.2 (A), K33.2 (B)
unnamed: D40.2 (A), K40.2 (B)
unnamed: D41.2 (A), K41.2 (B)
unnamed: D42.2 (A), K42.2 (B)
unnamed: D43.2 (A), K43.2 (B)
unnamed: D101.2 (A), R105.2
unnamed: JP0.1 (A), R304.1, U3.15 (A0)
unnamed: JP1.1 (A), R303.1, U3.16 (A1)
unnamed: JP2.1 (A), R302.1, U3.17 (A2)
unnamed: R104.2, R105.1, U1.5 (READY)
unnamed: R301.1, U3.18 (~RESET~)
unnamed: RV201.2, VR202.X1, VR202.Y1
VCC: C101.2, J1.4, J2.4, JP0.2 (B), JP1.2 (B), JP2.2 (B), R101.1, R102.1, R103.1, R104.1, R301.2, U1.8 (VCC), U2.15 (DVDD), U3.9 (VDD)

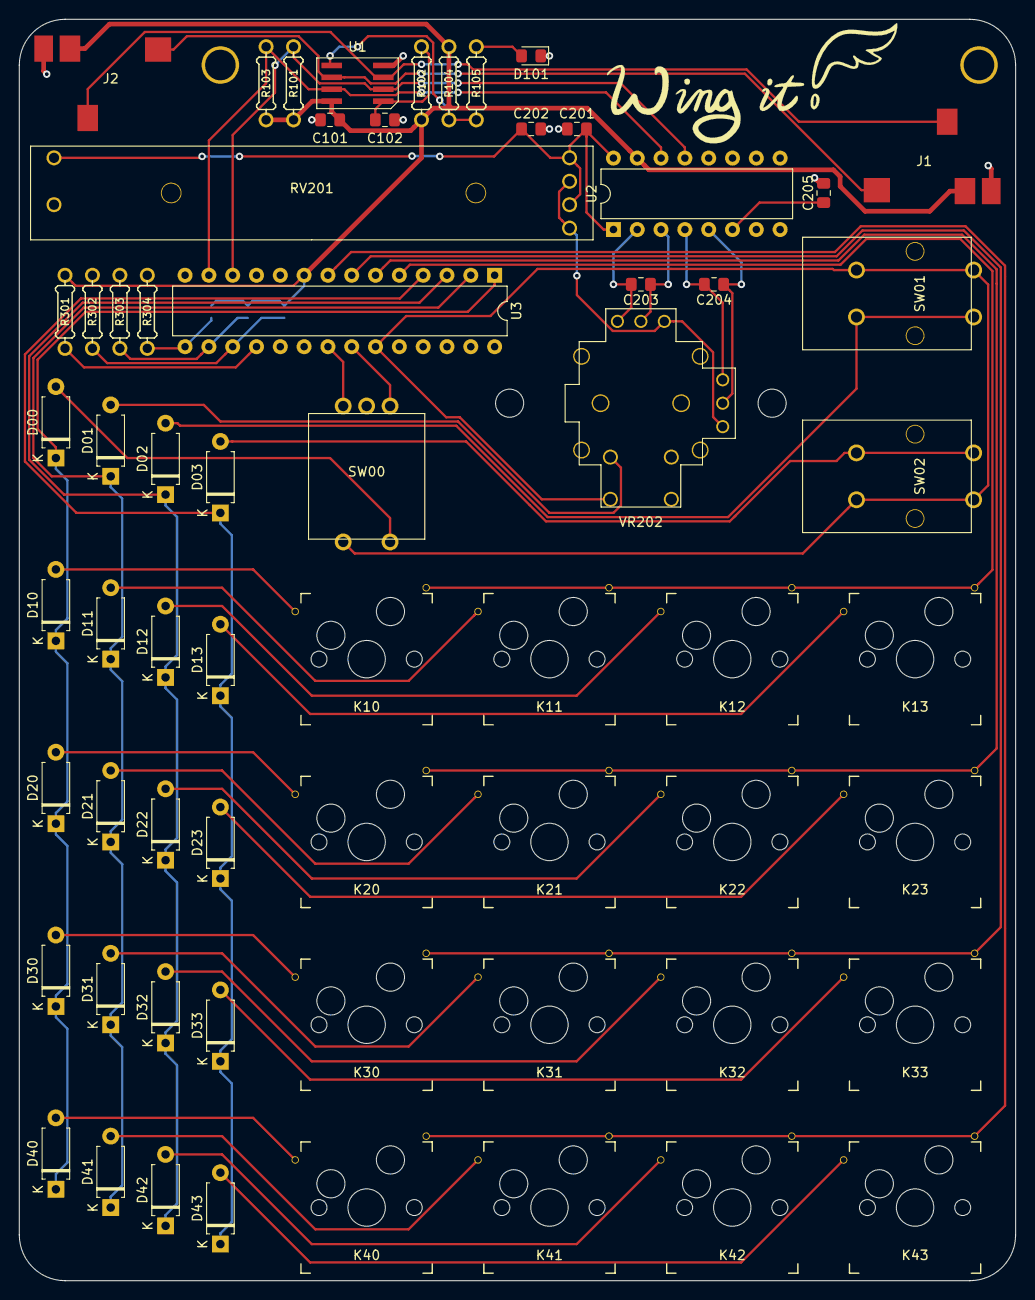
[picture p17: board keeb.module1.kicad_pcb from above]

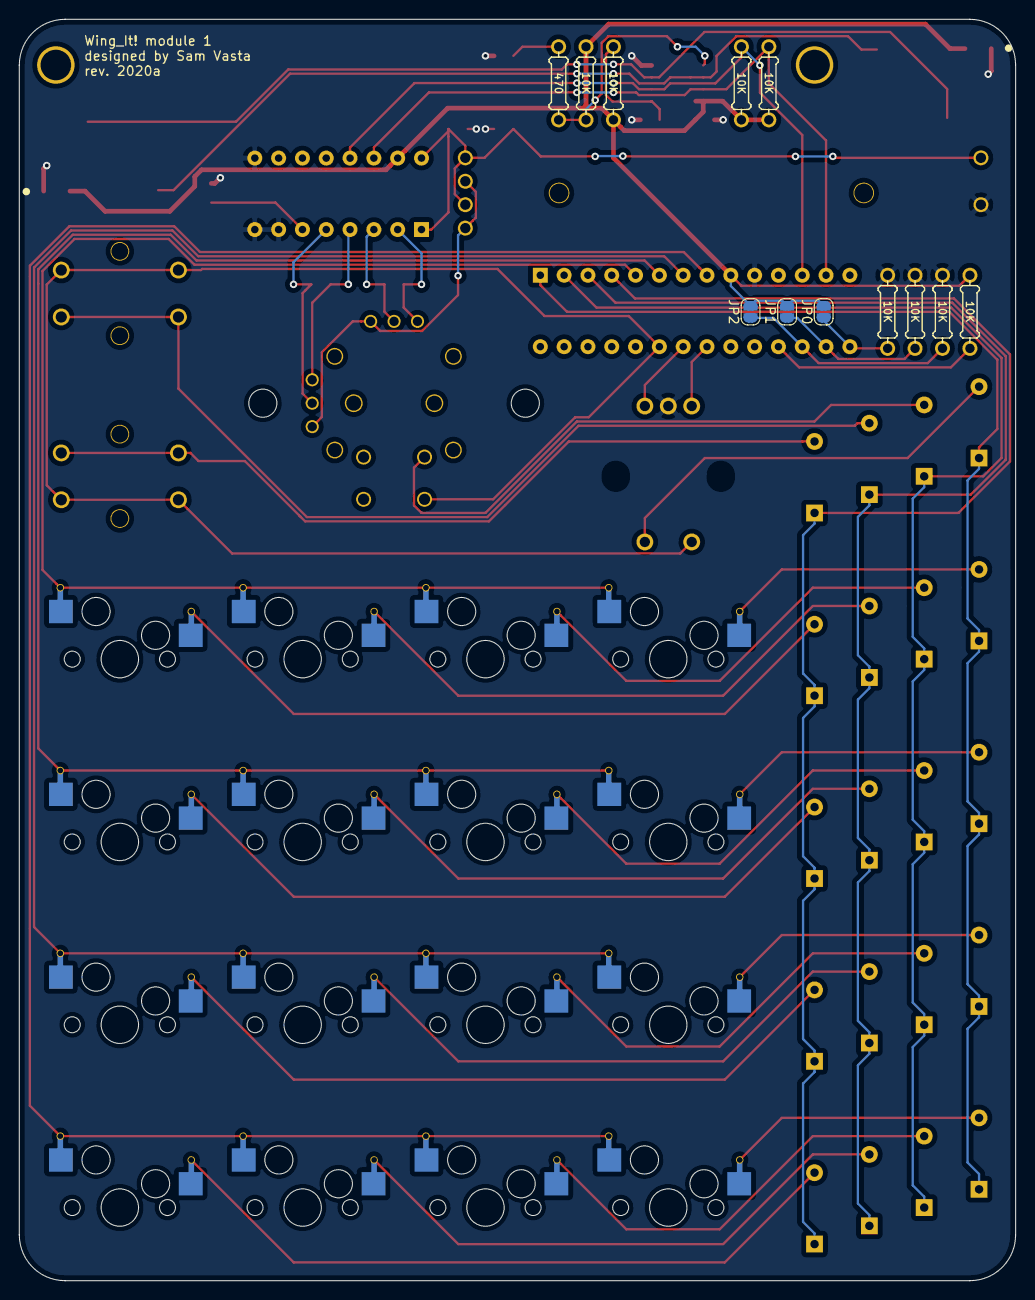
[picture p18: board keeb.module1.kicad_pcb from below]

Board: 2 copper layers, 106.3 x 134.6 mm, 66 parts (14 on the bottom side), 51 nets.
