samvasta/wing_it_hardware/(commit log)

2020-03-28 Fixed some mistakes in logic/layout from v1
    [Keeb.kicad_pcb, Keeb.sch]
2020-03-28 Added specs doc. for cad files
2020-03-28 Started minimal design cad drawing
    [all_in_one.dxf]
2020-03-29 Most pcb of layout done
    [BMS.sch, Keeb.kicad_pcb, Keeb.sch, SwitchMatrix.sch, kicad_import_switch_positions.dxf]
2020-03-29 Moved custom symbols & footprints into git submodules
    [Keeb.kicad_pcb, Keeb.sch, SwitchMatrix.sch]
2020-03-31 More layout work
    [BMS.sch, Keeb.kicad_pcb, Keeb.sch, SwitchMatrix.sch]
2020-03-31 Layout & cad work for split pcb design
    [Keeb.kicad_pcb, Keeb.sch, all_in_one.dxf, kicad_import_pcb_hand.dxf, kicad_import_pcb_main.dxf]
2020-04-02 First pass at split pcb design completed
    [BMS.sch, Keeb.kicad_pcb, Keeb.sch, SwitchMatrix.sch, all_in_one.dxf, bleModule.sch, kicad_import_pcb_hand.dxf, kicad_import_pcb_main.dxf]
2020-04-05 Completed first revision of module1, started on module 2
    [Keeb.kicad_pcb, SwitchMatrix.sch, bleModule.sch, keeb.module1.kicad_pcb, keeb.module1.sch, keeb.module2.kicad_pcb, keeb.module2.sch, thumbstick_tilt_guard.dxf]
2020-04-05 Rev 1 of module 2 & updated all-in-one cad drawing
    [Keeb.kicad_pcb, Keeb.sch, all_in_one.dxf, keeb.module2.kicad_pcb, keeb.module2.sch]
2020-04-14 Added dxf files to cut top/bottom plates
    [all_in_one.dxf, export_hand_bottom_plate.dxf, export_hand_top_plate.dxf]
2020-04-18 Updated connection method on main pcb
    [BMS.sch, Keeb.kicad_pcb, Keeb.sch, all_in_one.dxf]
2020-05-02 Updated layout to use hirose connectors
    [Keeb.kicad_pcb, Keeb.sch, kicad_import_pcb_hand2.dxf, kicad_import_pcb_main2.dxf]
2020-05-28 bms changes
    [#all_in_one.dxf, BMS.sch]
